nithinkasaragod/4DOF-Robotic-Arm/EBA_01.00.006_triangular_link.png

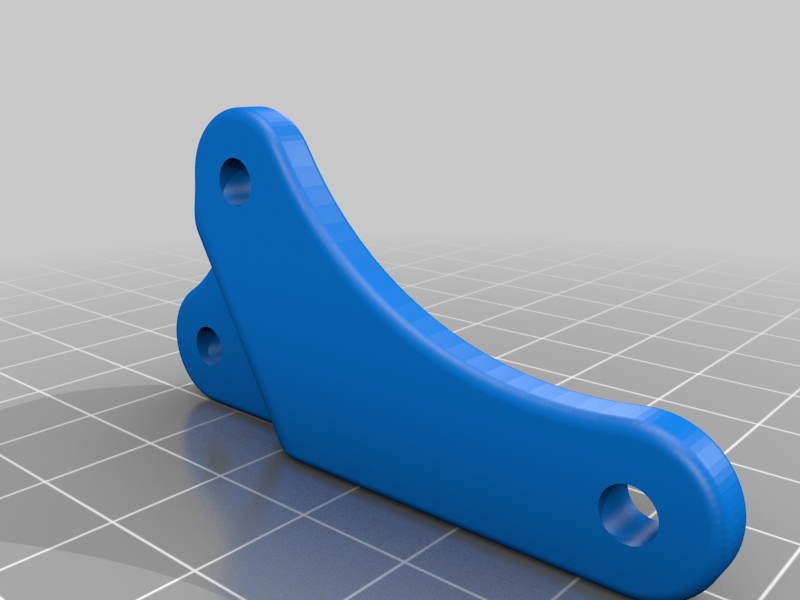
EBA_01.00.006_triangular_link.png
