nithinkasaragod/4DOF-Robotic-Arm/EBA_01.00.015_drive_gear.png

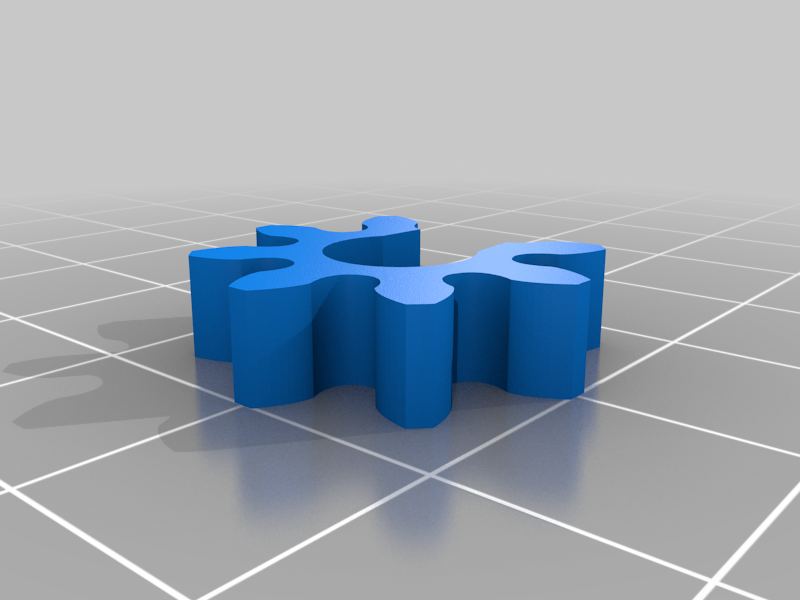
EBA_01.00.015_drive_gear.png
