nithinkasaragod/4DOF-Robotic-Arm/README.md

# 4DOF-Robotic-Arm
The 4DOF Robotic Arm is an Arduino-controlled manipulator designed for precise object handling and automation tasks. Featuring four degrees of freedom powered by servo motors, it performs pick-and-place operations with accuracy. Its simple design and control make it ideal for education and small-scale automation.
