nithinkasaragod/4DOF-Robotic-Arm/4 DOF 3.png

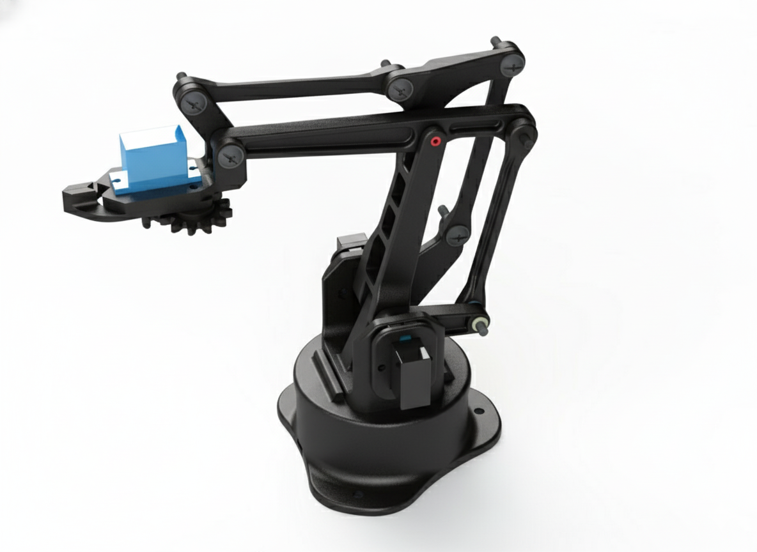
4 DOF 3.png
