nithinkasaragod/4DOF-Robotic-Arm/4DOF 1.png

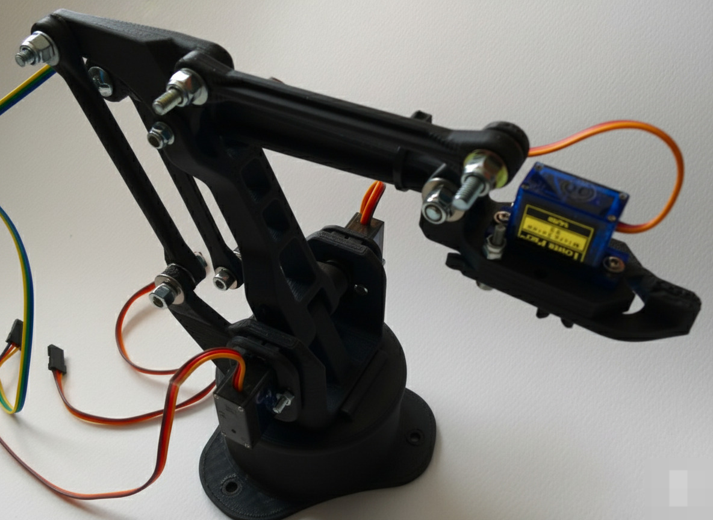
4DOF 1.png
