nithinkasaragod/4DOF-Robotic-Arm/4DOF 2.png

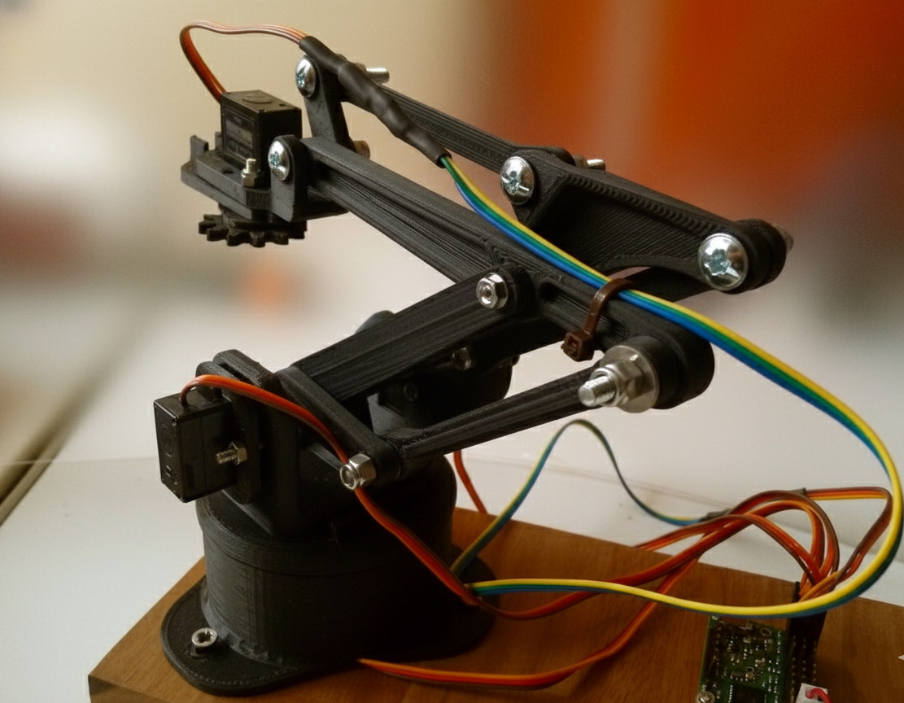
4DOF 2.png
