nithinkasaragod/4DOF-Robotic-Arm/4DOF 4.jpeg

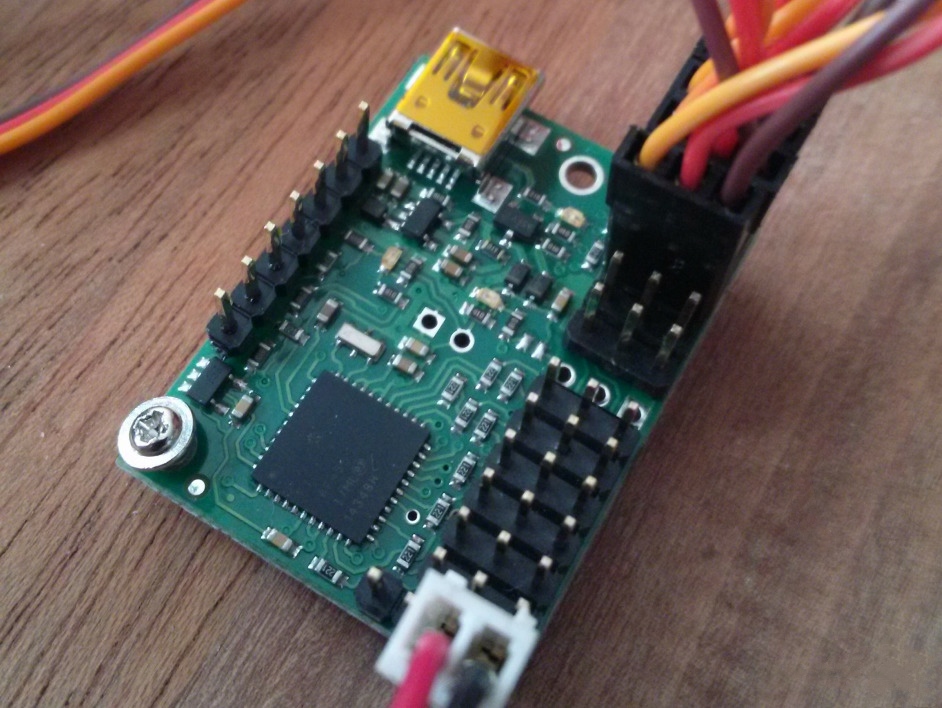
4DOF 4.jpeg
