nithinkasaragod/4DOF-Robotic-Arm/EBA_01.00.001.png

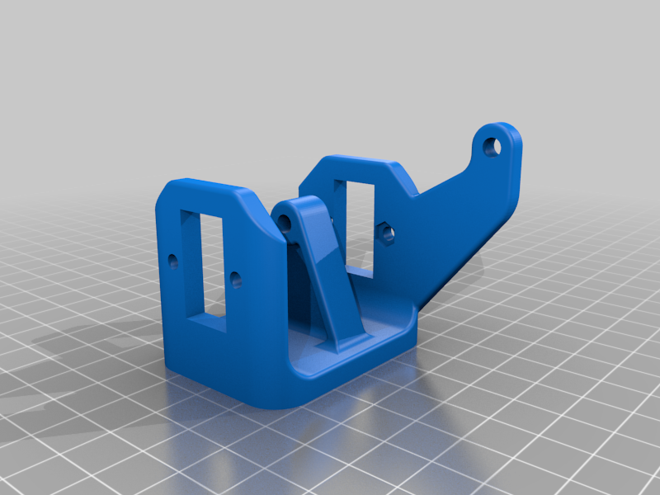
EBA_01.00.001.png
