nithinkasaragod/4DOF-Robotic-Arm/EBA_01.00.002_vertical_drive_arm.png

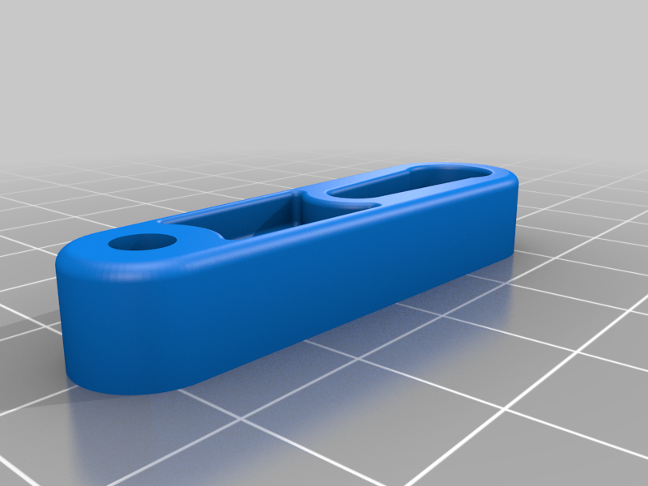
EBA_01.00.002_vertical_drive_arm.png
