nithinkasaragod/4DOF-Robotic-Arm/EBA_01.00.003_link.png

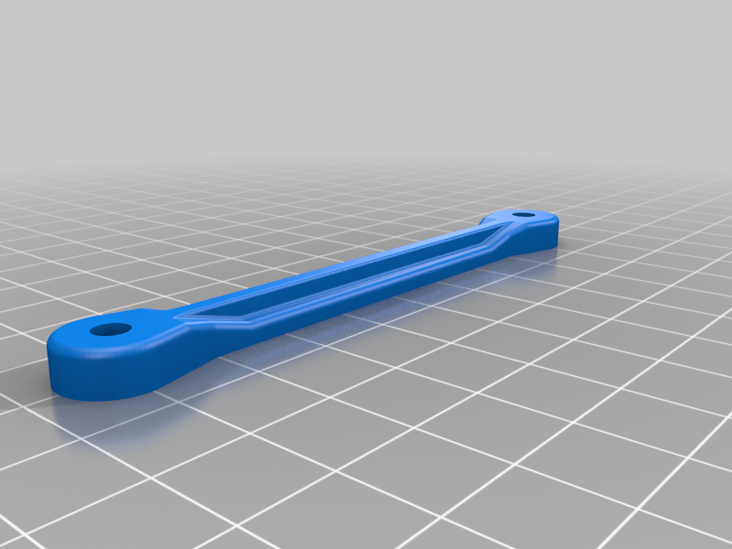
EBA_01.00.003_link.png
