nithinkasaragod/4DOF-Robotic-Arm/EBA_01.00.004_forward_drive_arm.png

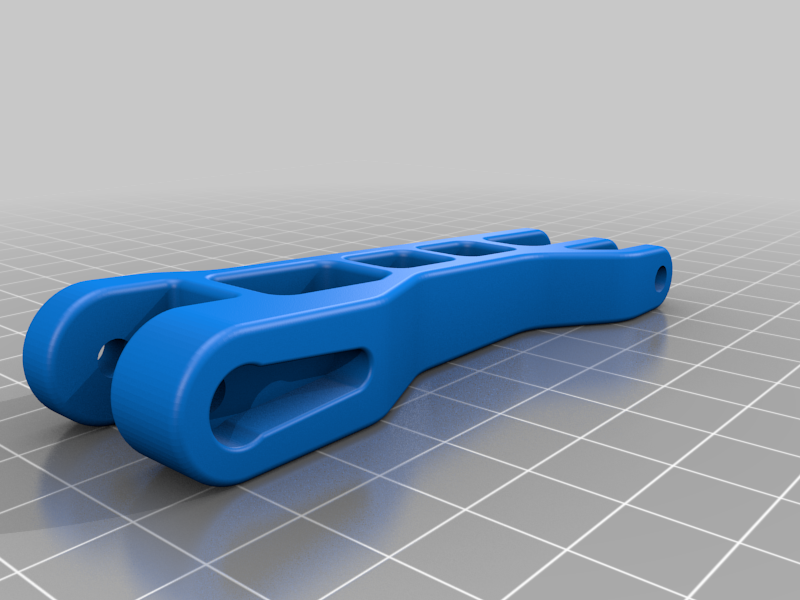
EBA_01.00.004_forward_drive_arm.png
