nithinkasaragod/4DOF-Robotic-Arm/EBA_01.00.005_horizontal_arm.png

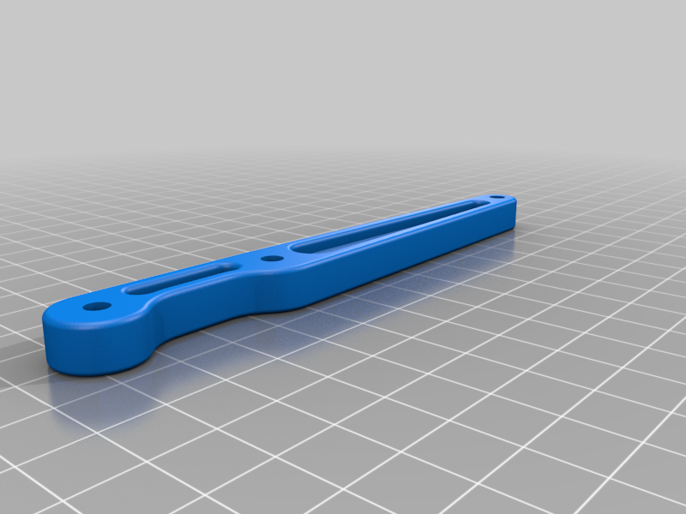
EBA_01.00.005_horizontal_arm.png
