nithinkasaragod/4DOF-Robotic-Arm/EBA_01.00.009_servo_plate.png

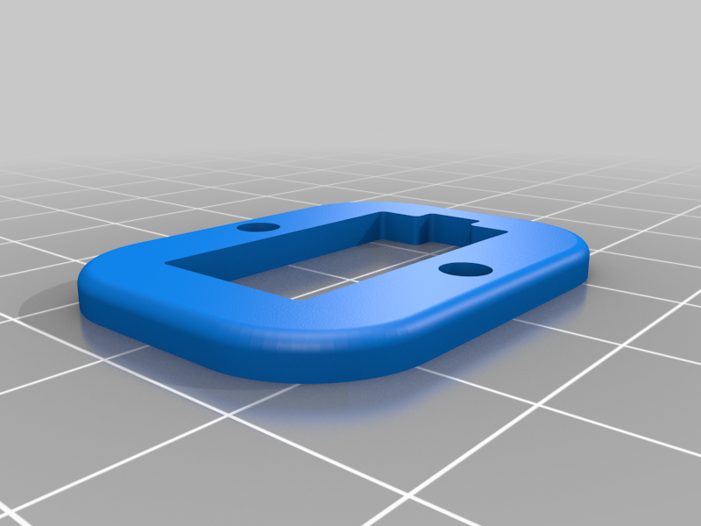
EBA_01.00.009_servo_plate.png
