nithinkasaragod/4DOF-Robotic-Arm/EBA_01.00.010_basement.png

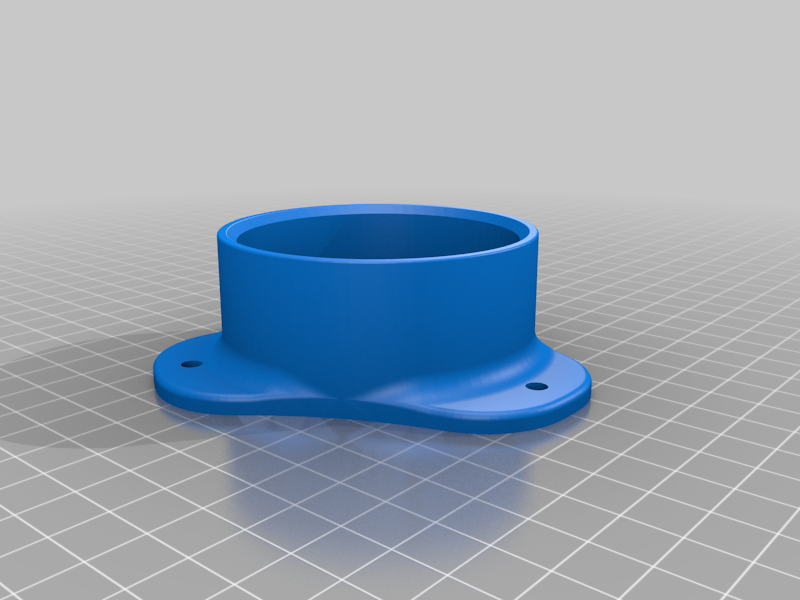
EBA_01.00.010_basement.png
