nithinkasaragod/4DOF-Robotic-Arm/EBA_01.00.011_round_plate.png

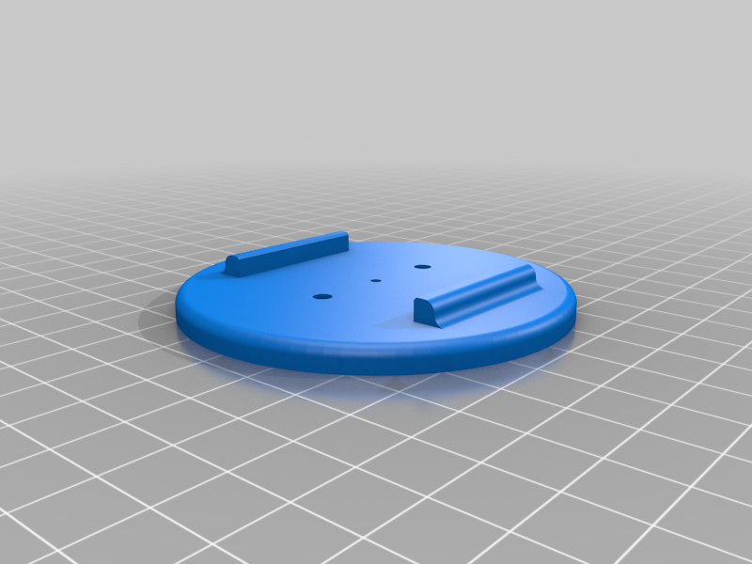
EBA_01.00.011_round_plate.png
