nithinkasaragod/4DOF-Robotic-Arm/EBA_01.00.012_R01_claw_support.png

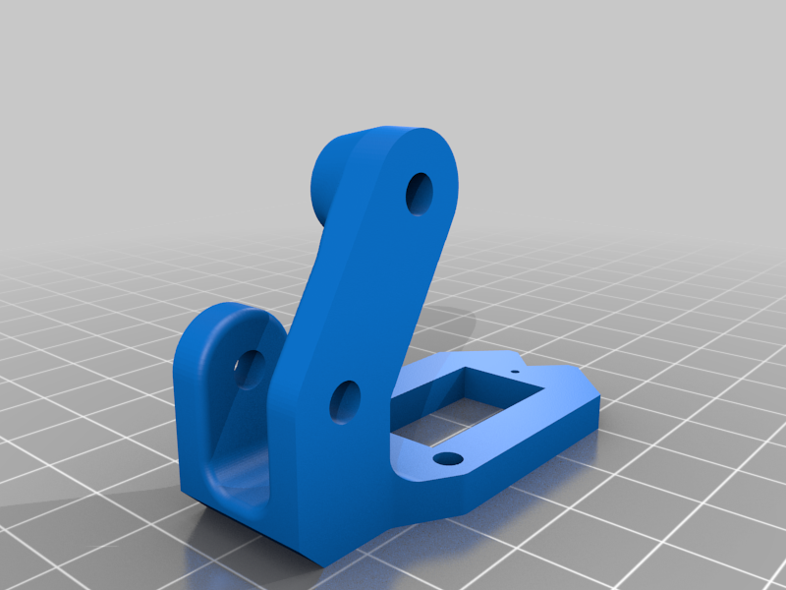
EBA_01.00.012_R01_claw_support.png
