nithinkasaragod/4DOF-Robotic-Arm/EBA_01.00.013_R01_right_finger.png

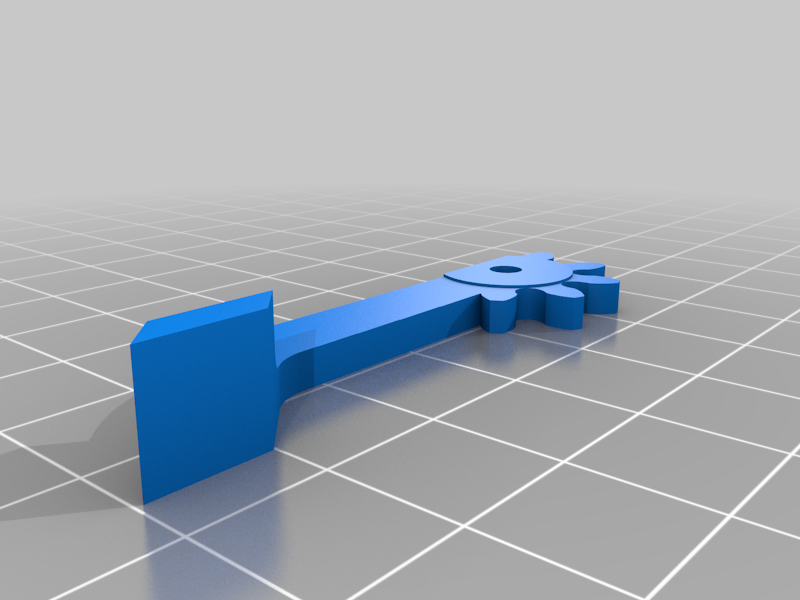
EBA_01.00.013_R01_right_finger.png
