nithinkasaragod/4DOF-Robotic-Arm/EBA_01.00.014_R01_left_finger.png

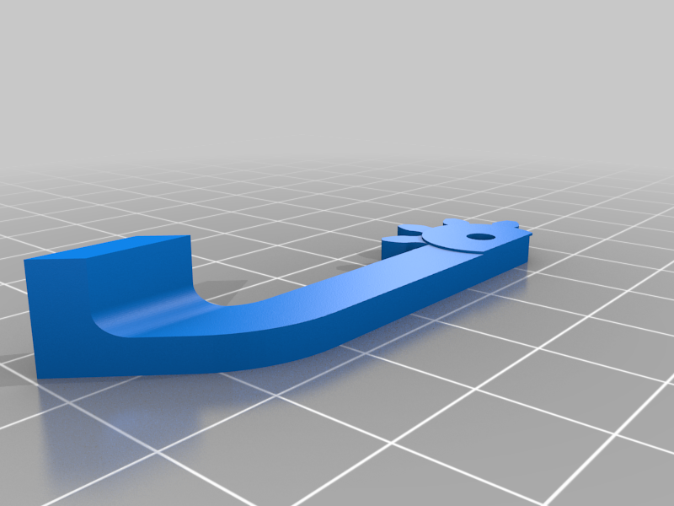
EBA_01.00.014_R01_left_finger.png
