nithinkasaragod/4DOF-Robotic-Arm/EBA_01.00.016_R01_driven_gear.png

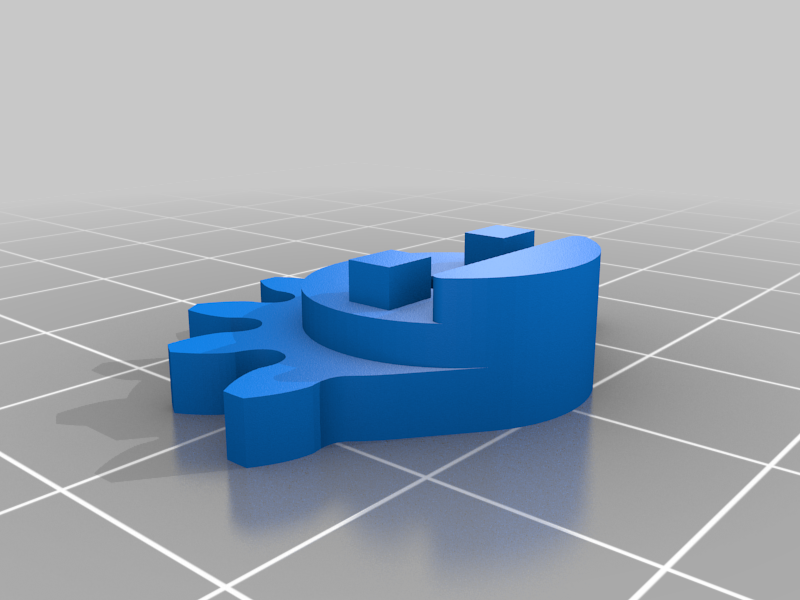
EBA_01.00.016_R01_driven_gear.png
