nithinkasaragod/4DOF-Robotic-Arm/EBA_thing_04.png

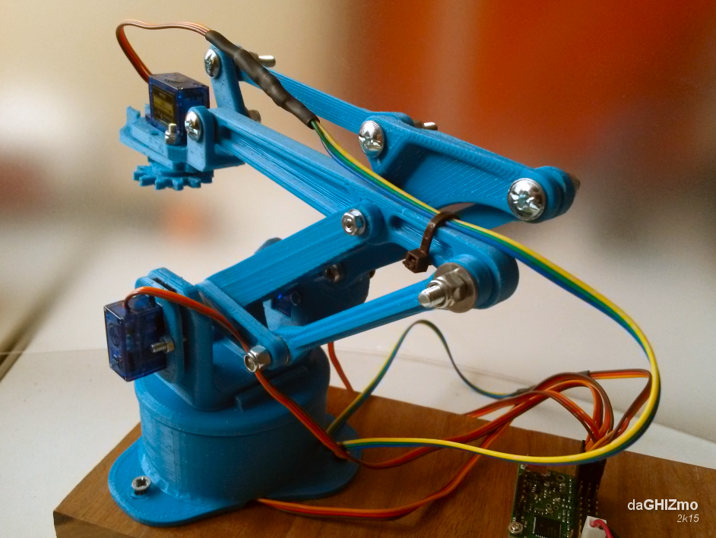
EBA_thing_04.png
