nithinkasaragod/4DOF-Robotic-Arm/EBA_thing_05.png

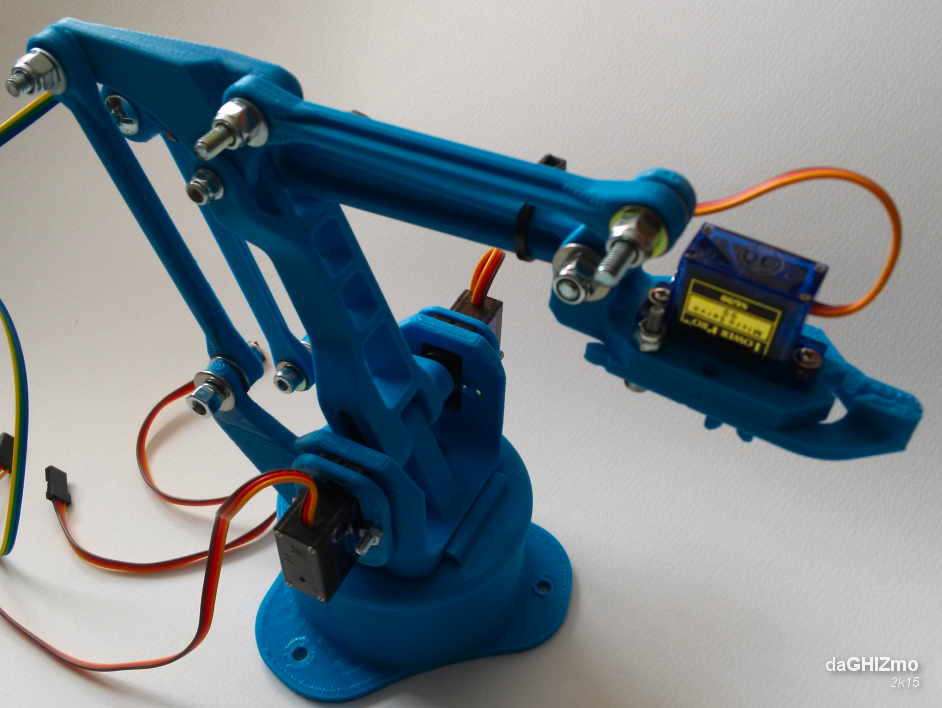
EBA_thing_05.png
