nithinkasaragod/4DOF-Robotic-Arm/Schematic_Bluetooth Robot Arm_2021-01-04.pdf

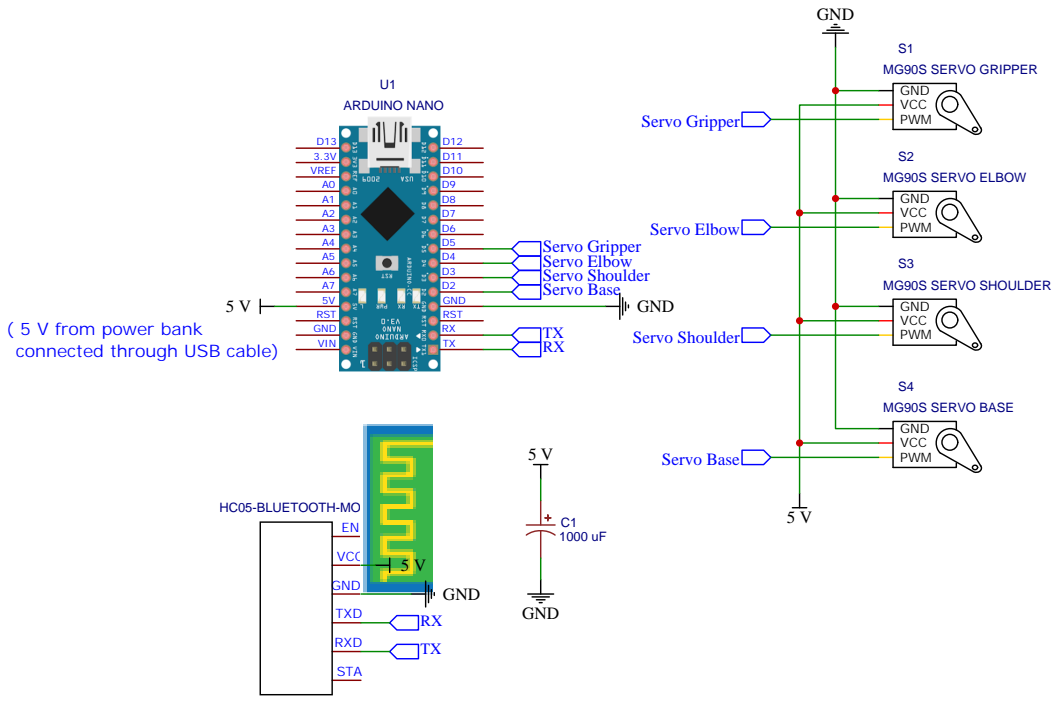
[picture p51: page 1]

( 5 V from power bank
connected through USB cable)
